dronsuab/IR_Project/Specs/Informes/CapturaIvan.PNG

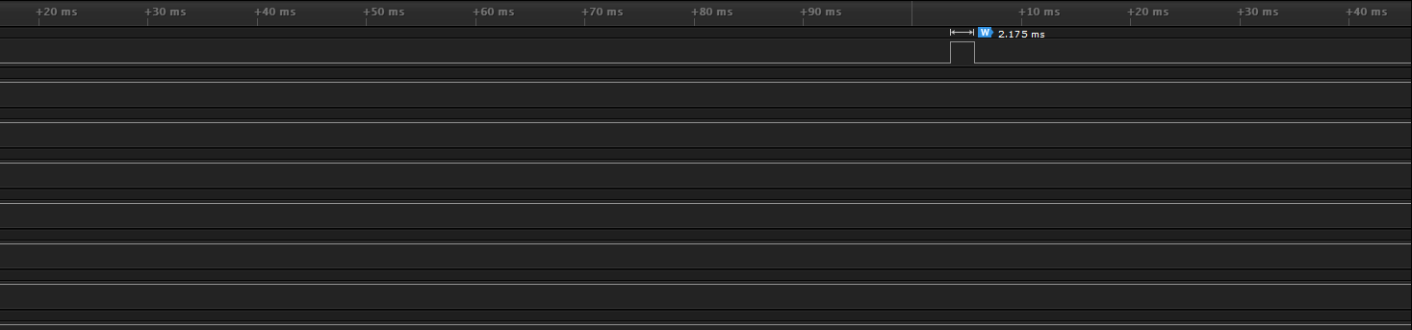
Specs/Informes/CapturaIvan.PNG
