dronsuab/IR_Project/Specs/NRST PIN.png

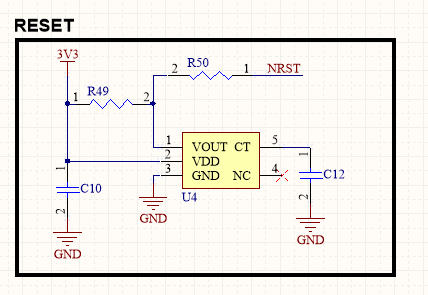
Specs/NRST PIN.png
