dronsuab/IR_Project/Specs/TFDU4101_CONNECTION.jpg

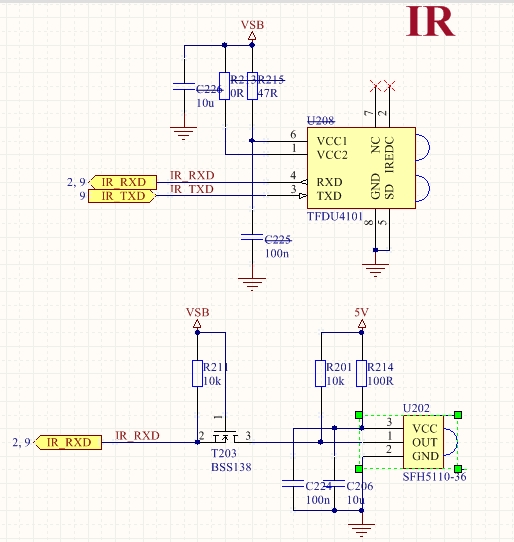
Specs/TFDU4101_CONNECTION.jpg
