dronsuab/IR_Project/Specs/VBAT.png

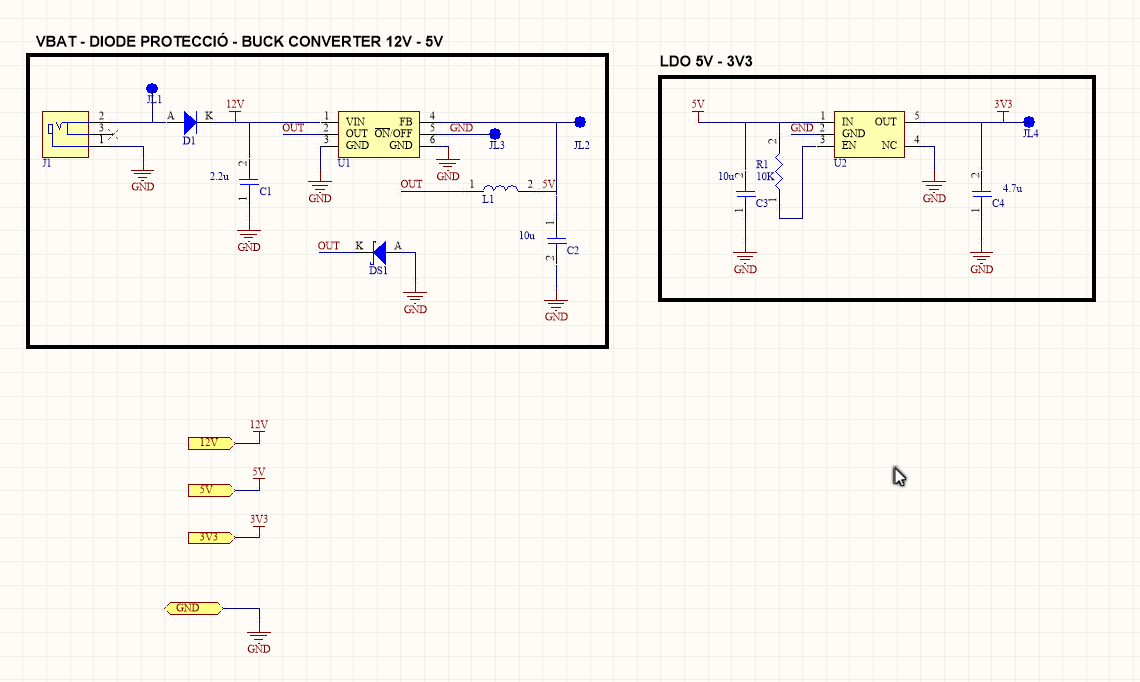
Specs/VBAT.png
