dronsuab/IR_Project/PCB/Kicad PCB/PCB/IDFReport_prueba.html

Altium customize

# IDF File Translation Report

Date: | | 6/22/2018
Time: | | 10:10:23 AM
Elapsed Time: | | 00:00:00
PCB Filename | : | PCB1.PcbDoc
IDF Board Filename | : | C:\Users\FV4IYP0\Documents\GitHub\IR_Project\PCB\Kicad PCB\PCB\prueba.emn
IDF Library Filename | : | C:\Users\FV4IYP0\Documents\GitHub\IR_Project\PCB\Kicad PCB\PCB\prueba.emp

Load Errors

Back to top

Import Errors

Back to top

Load Warnings

Back to top

Import Warnings

One or more via/pin drilled holes were ignored

Back to top

Errors

Back to top

Warnings

Back to top
