dronsuab/IR_Project/PCB/Kicad PCB/PCB/ST_IRDA_PCB.pdf

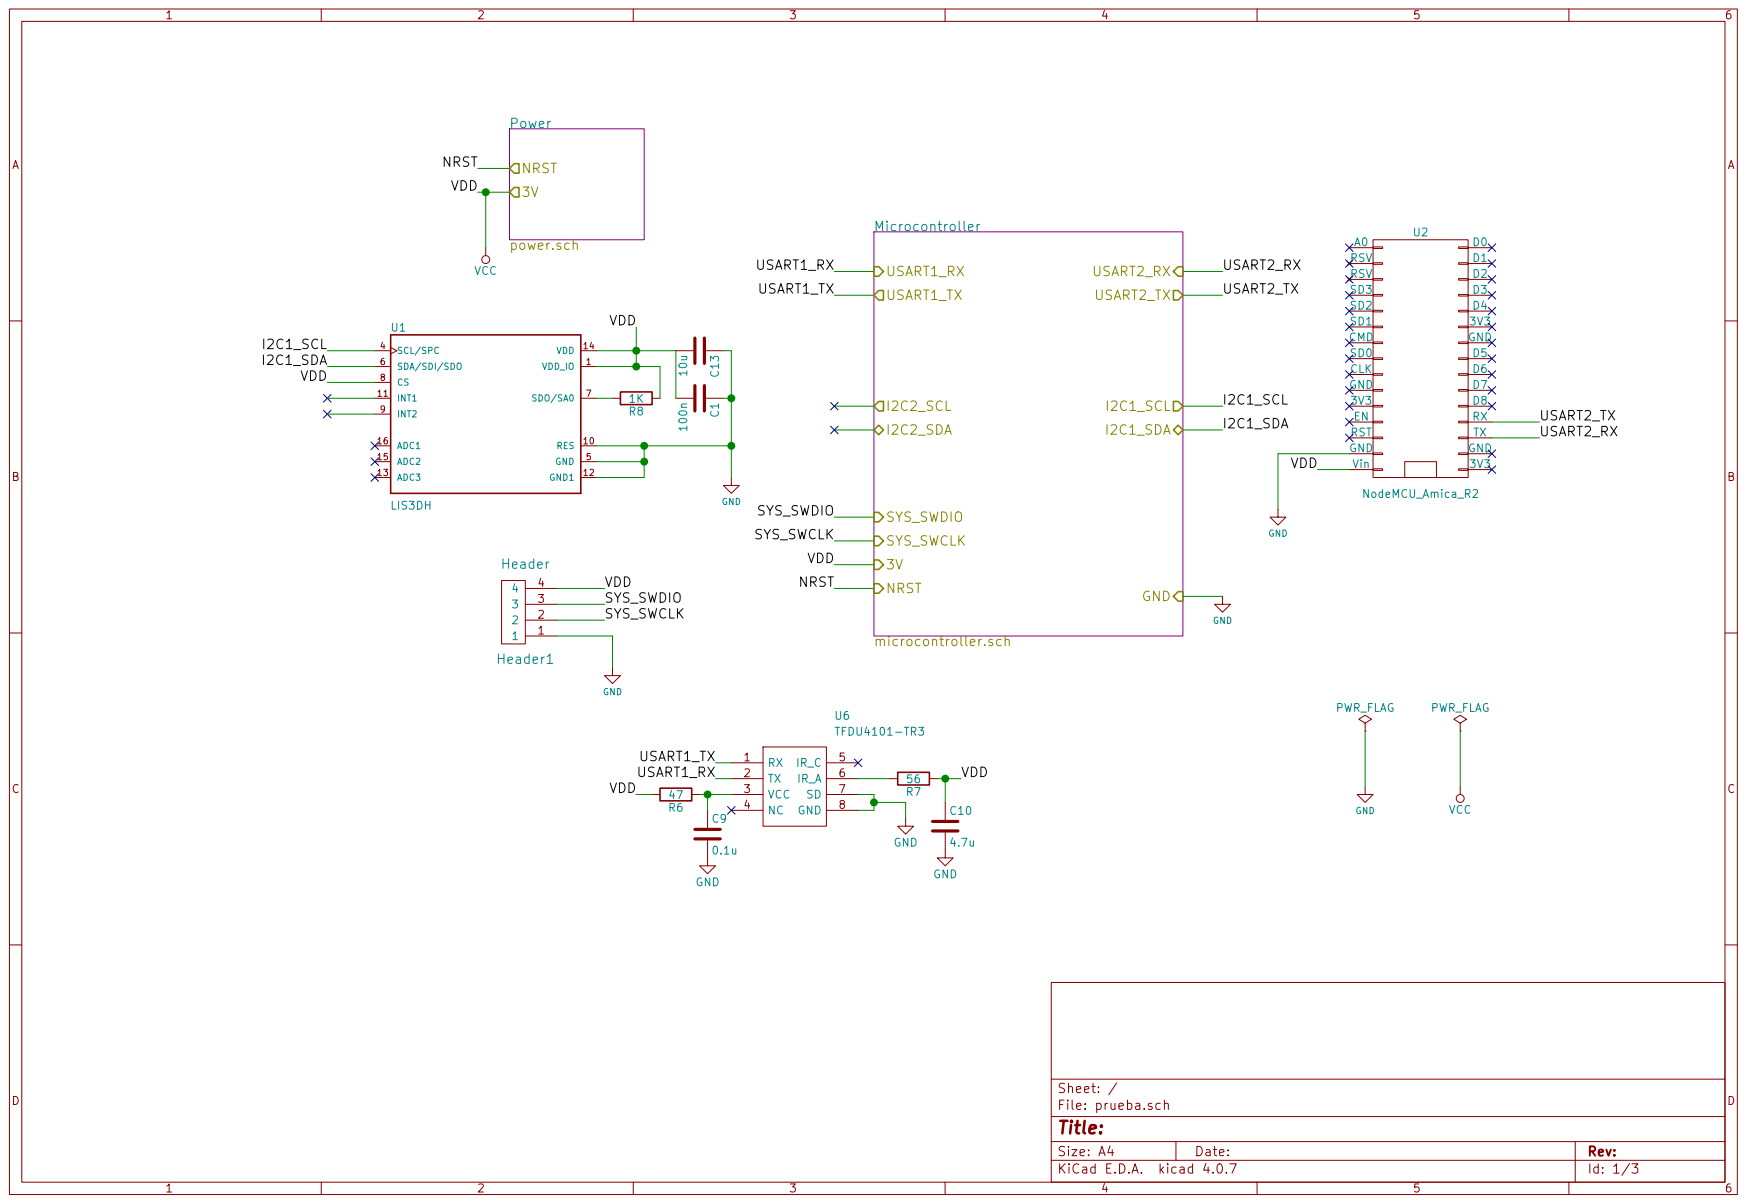
[picture p9: page 1]

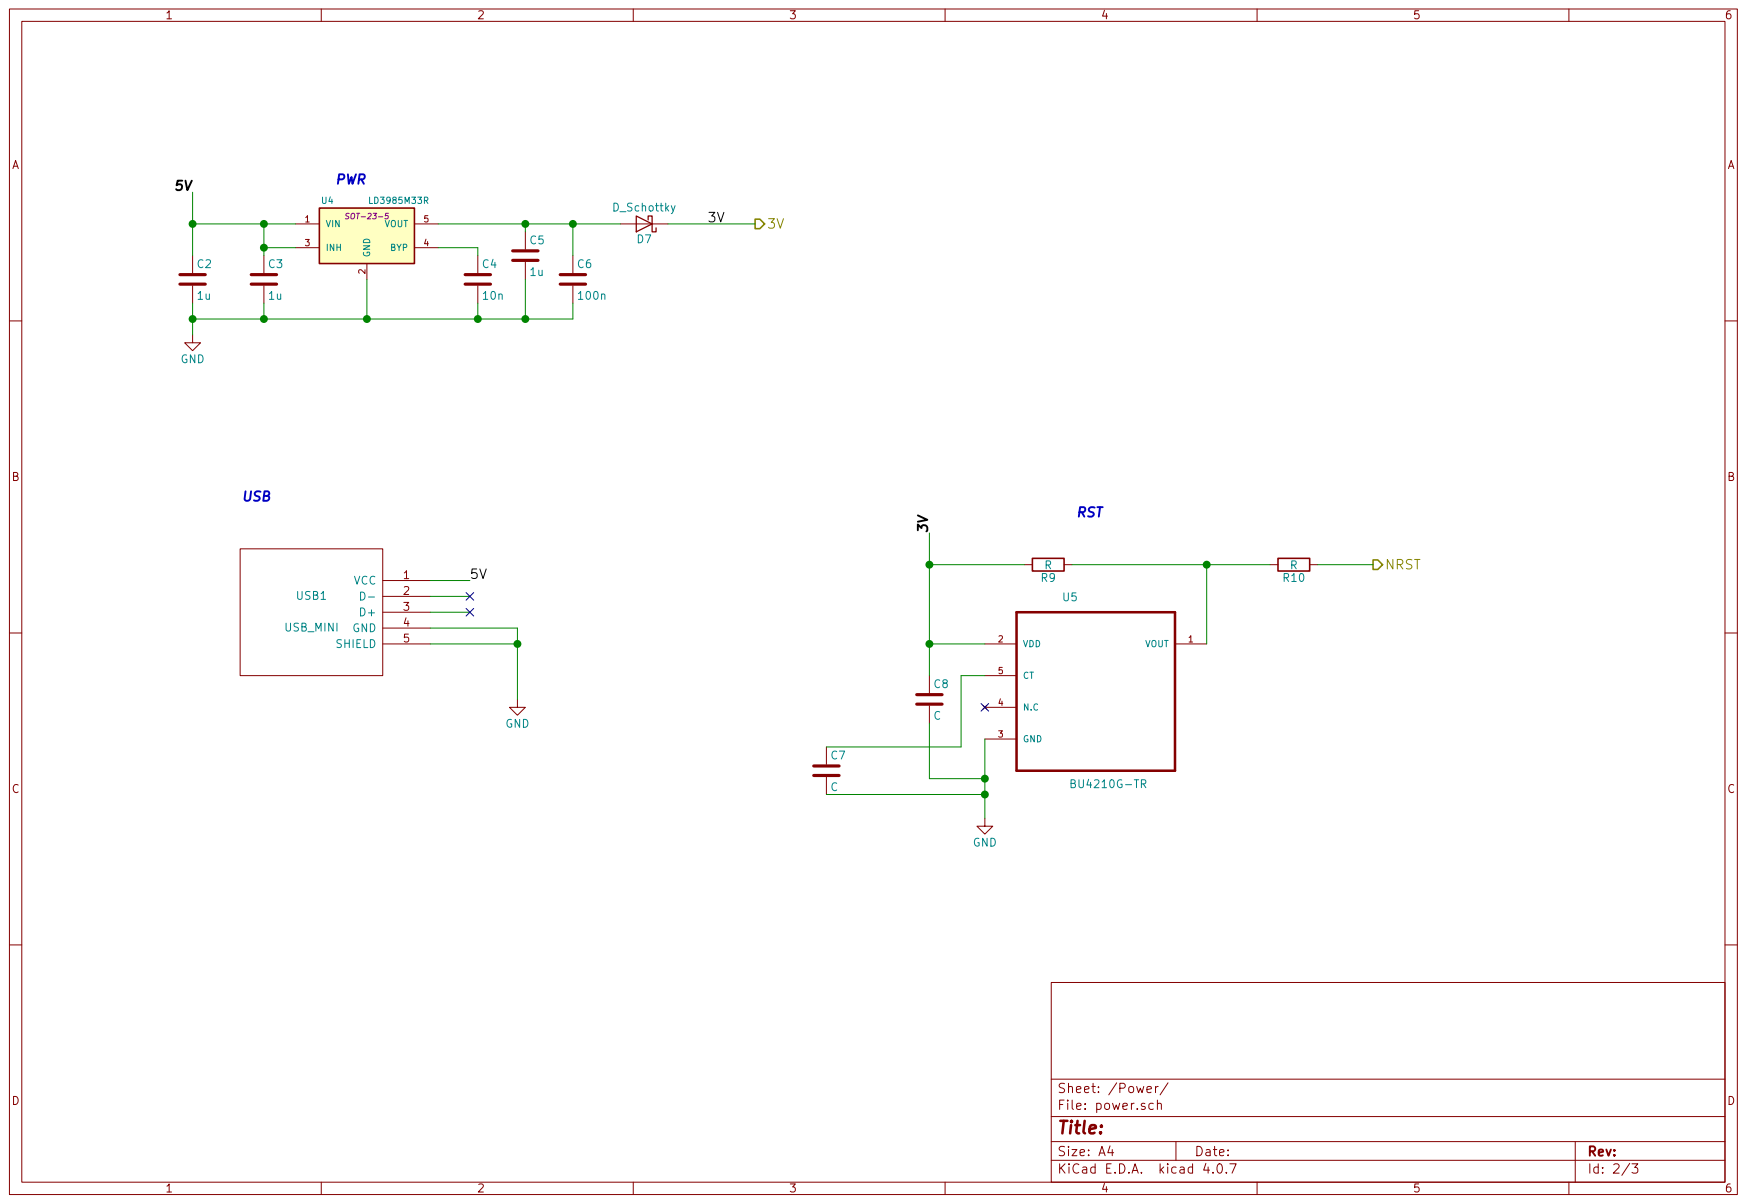
[picture p10: page 2]

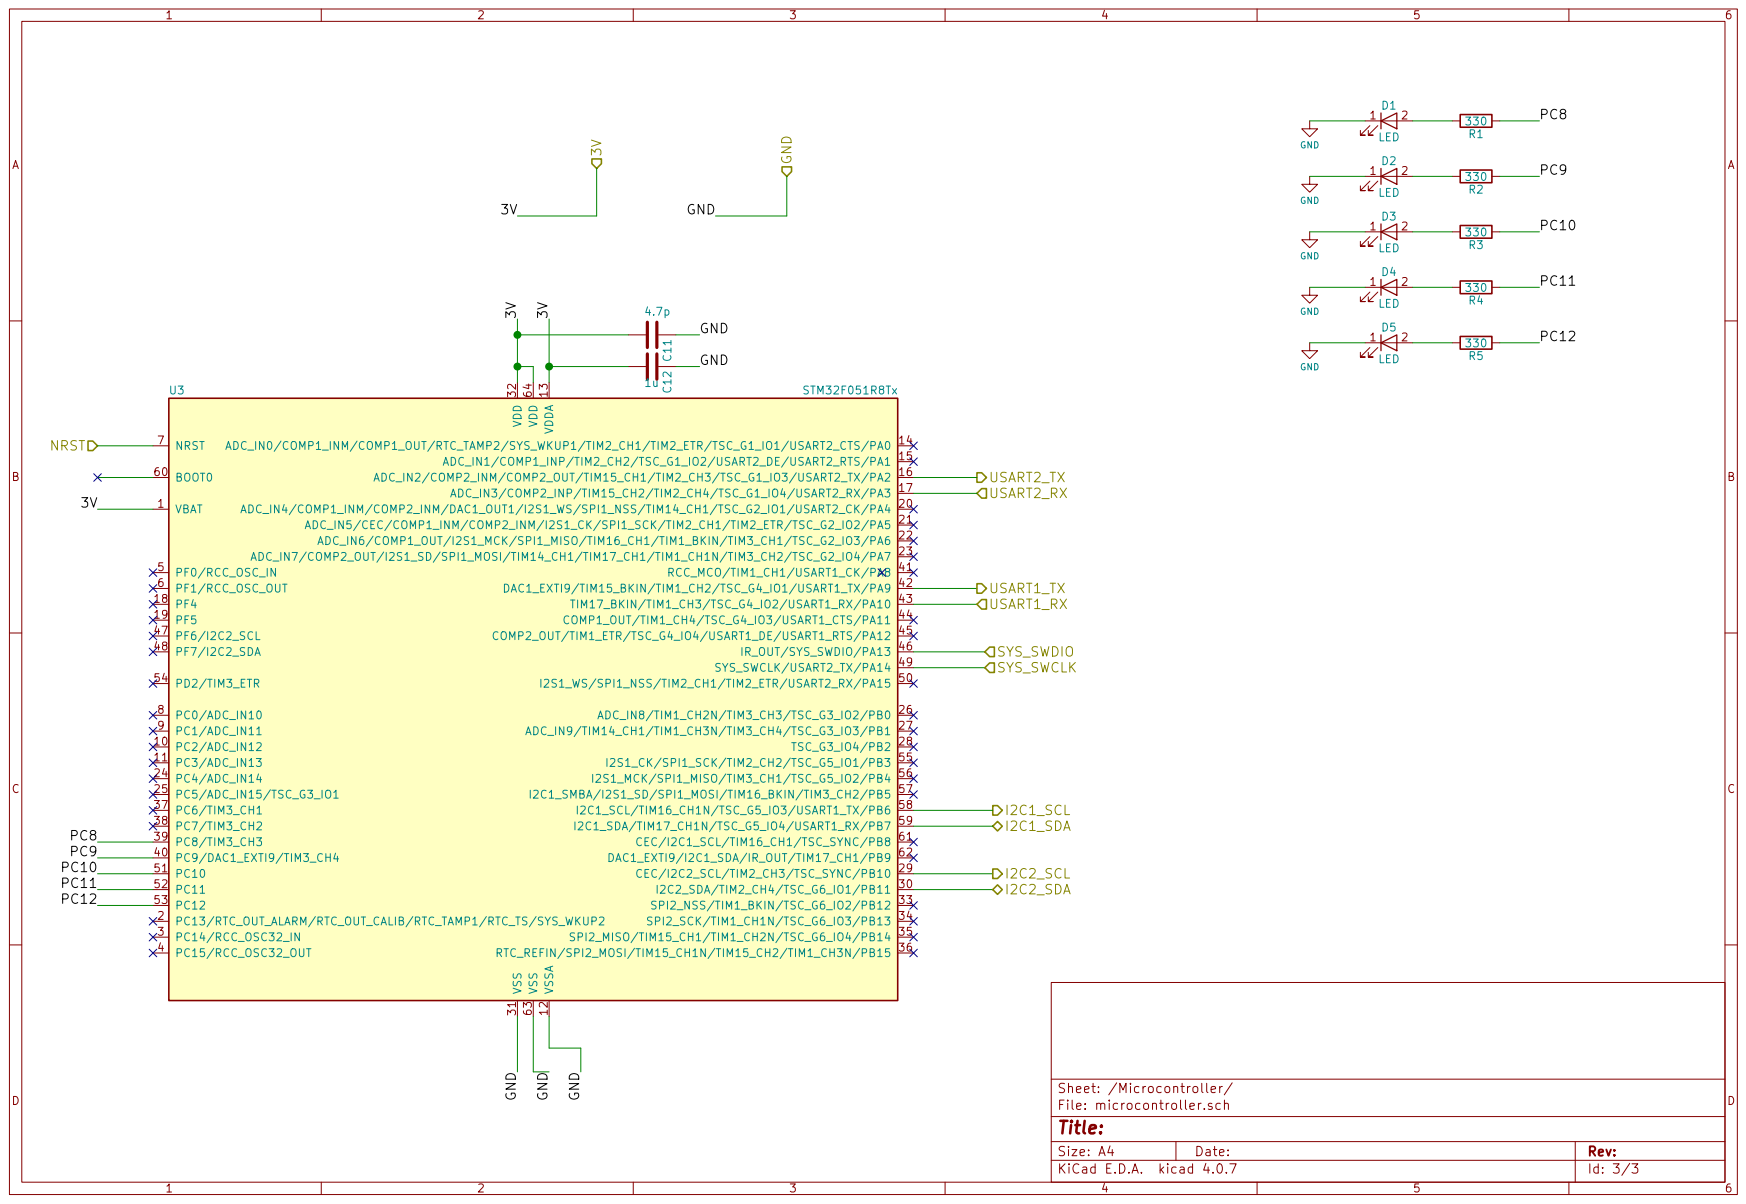
[picture p11: page 3]
