dronsuab/IR_Project/(list of files, drawings)

Other design files:
PCB/Kicad PCB/PCB/prueba2.dsn
PCB/Kicad PCB/PCB/prueba3.dsn
PCB/Kicad PCB/PCB/prueba4.dsn
PCB/Kicad PCB/PCB/prueba5.dsn
PCB/Kicad PCB/PCB/prueba.dsn
PCB/Kicad PCB/PCB/prueba.pcb
