dronsuab/IR_Project/PCB/Kicad PCB/PCB/prueba.kicad_pcb

## KiCad design PCB/Kicad PCB/PCB/prueba.kicad_pcb (2018-07-02)

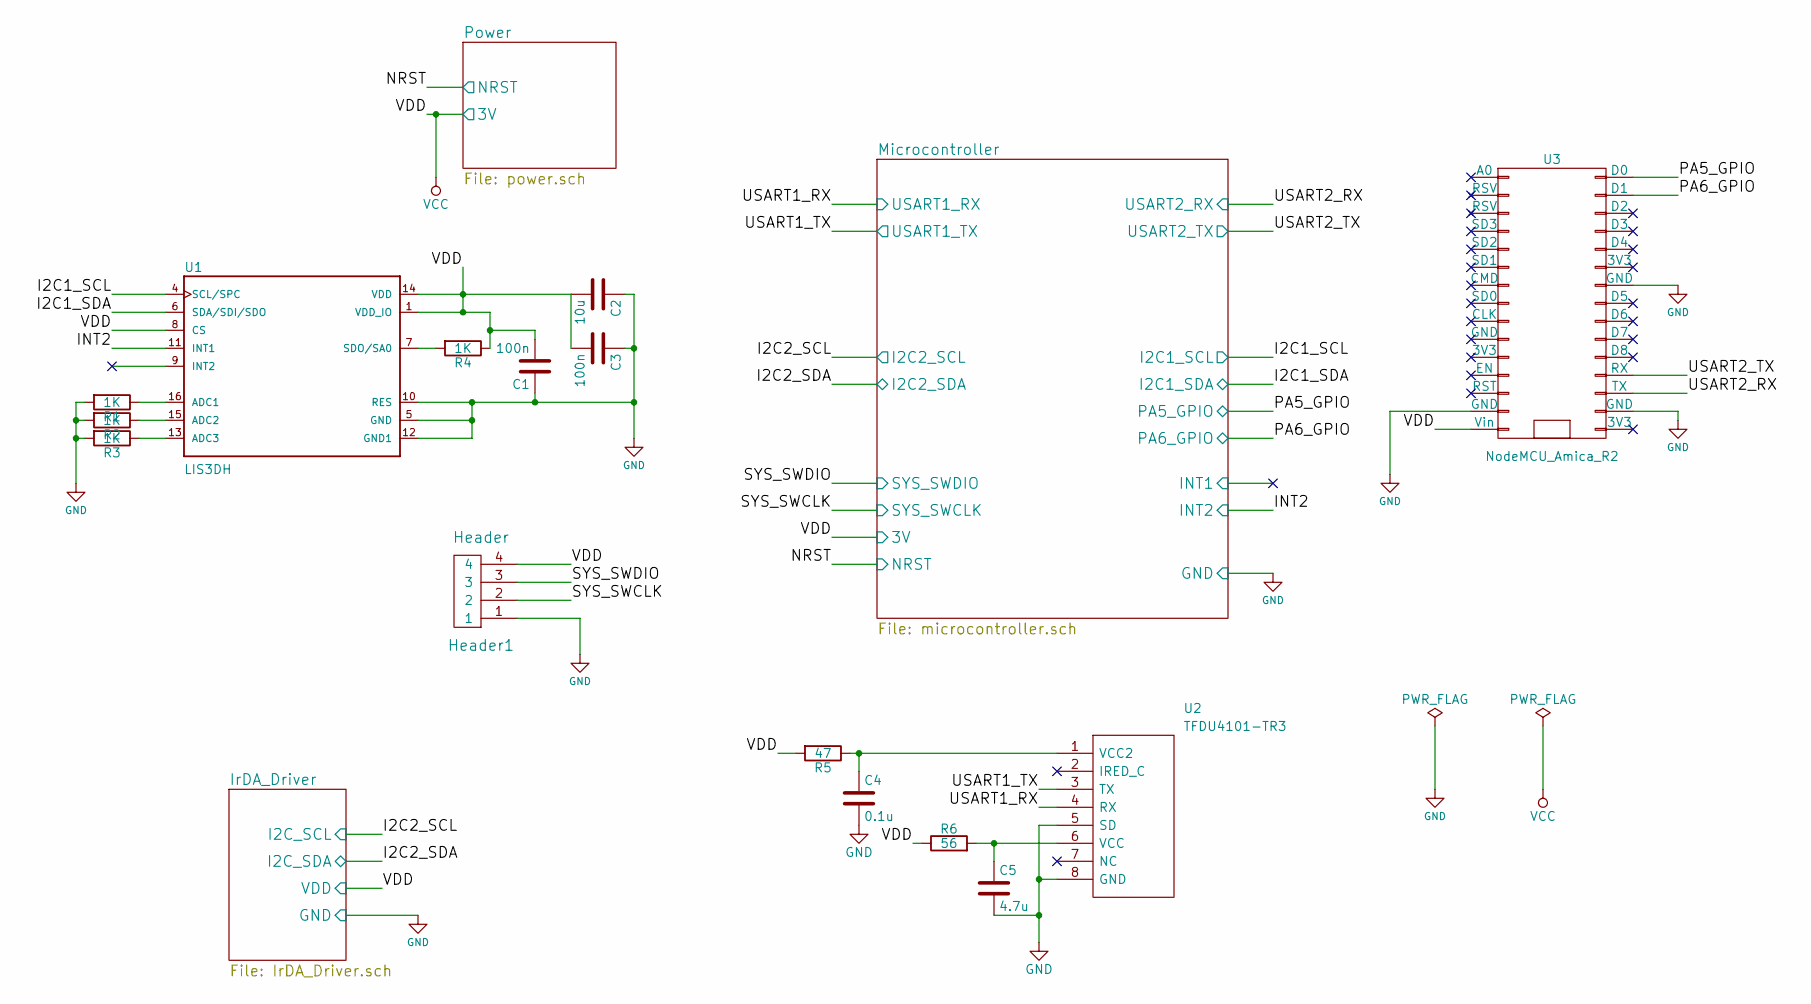
[picture p12: schematic prueba.sch]

Parts:
C1, C3: 100n; C_0201
C2: 10u; C_0201
C4: 0.1u; C_0201
C5: 4.7u; C_0201
Header1: Header; DIP-4_W7.62mm
R1, R2, R3, R4: 1K; R_0201
R5: 47; R_0201
R6: 56; R_0201
U1: LIS3DH; PQFN50P300X300X100-16N
U2: TFDU4101-TR3; Manufacturer_Part_Number TFDU4101-TR3
U3: NodeMCU_Amica_R2

Connections:
/I2C1_SCL: U1.4 (SCL/SPC); also elsewhere on the board
/I2C1_SDA: U1.6 (SDA/SDI/SDO); also elsewhere on the board
/INT2: U1.11 (INT1); also elsewhere on the board
/PA5_GPIO: U3.30 (D0); also elsewhere on the board
/PA6_GPIO: U3.29 (D1); also elsewhere on the board
/SYS_SWCLK: Header1.2; also elsewhere on the board
/SYS_SWDIO: Header1.3; also elsewhere on the board
/USART1_RX: U2.4 (RX); also elsewhere on the board
/USART1_TX: U2.3 (TX); also elsewhere on the board
/USART2_RX: U3.18 (TX); also elsewhere on the board
/USART2_TX: U3.19 (RX); also elsewhere on the board
GND: C1.1, C2.1, C3.1, C4.2, C5.2, Header1.1, R1.2, R2.2, R3.2, U1.5 (GND), U1.10 (RES), U1.12 (GND1), U2.5 (SD), U2.8 (GND), U3.14 (GND), U3.17 (GND), U3.24 (GND); also elsewhere on the board
unnamed: C4.1, R5.1, U2.1 (VCC2)
unnamed: C5.1, R6.2, U2.6 (VCC)
unnamed: R1.1, U1.16 (ADC1)
unnamed: R2.1, U1.15 (ADC2)
unnamed: R3.1, U1.13 (ADC3)
unnamed: R4.2, U1.7 (SDO/SA0)
VCC: C1.2, C2.2, C3.2, Header1.4, R4.1, R5.2, R6.1, U1.1 (VDD_IO), U1.8 (CS), U1.14 (VDD), U3.15 (Vin); also elsewhere on the board

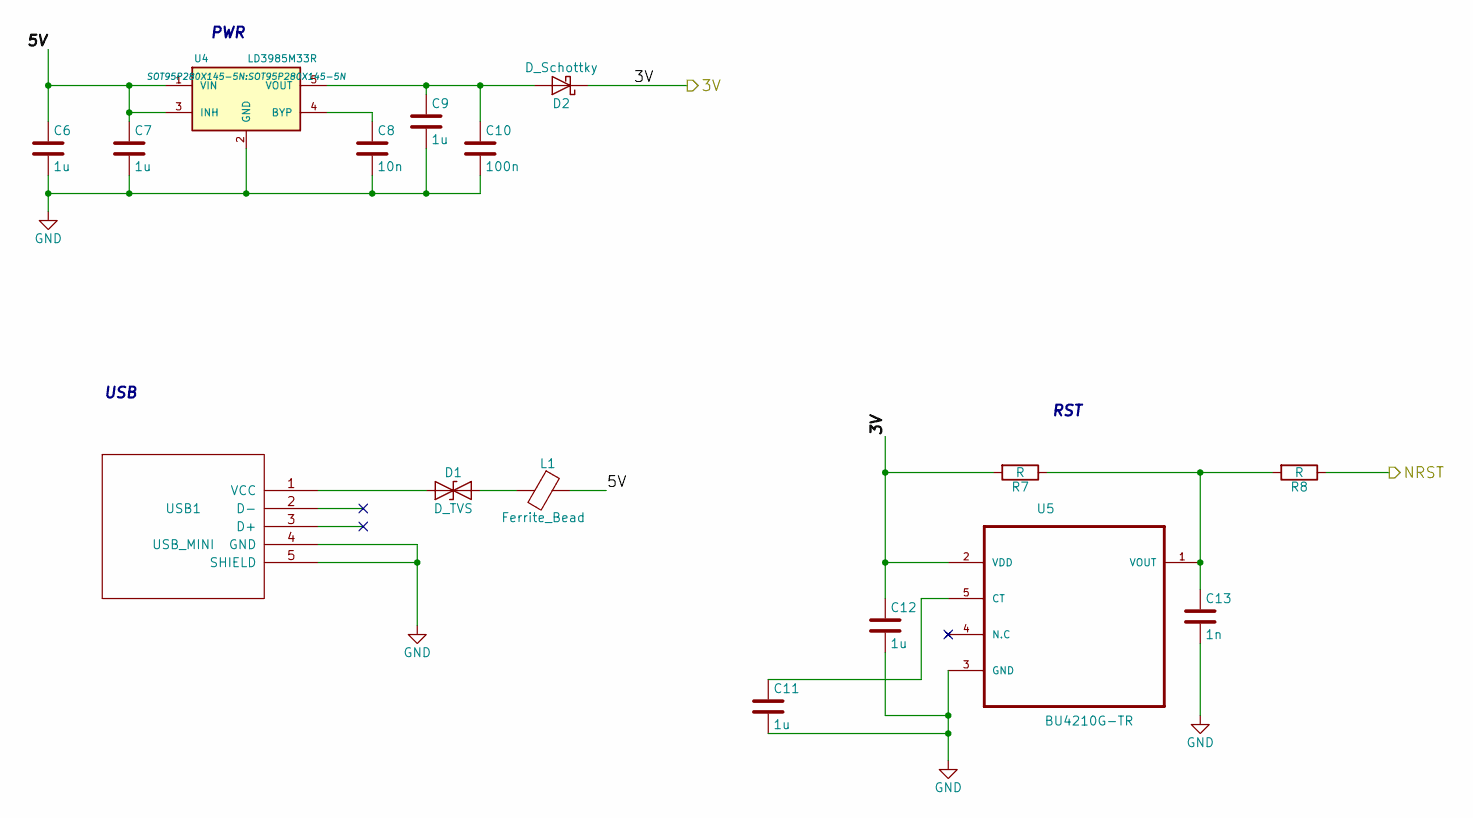
[picture p13: schematic power.sch]

Parts:
C6, C7, C9, C11, C12: 1u; C_0201
C8: 10n; C_0201
C10: 100n; C_0201
C13: 1n; C_0201
D1: D_TVS; D_0603
D2: D_Schottky; D_0603
L1: Ferrite_Bead; 0603-NO
R7, R8: R; R_0201
U4: LD3985M33R; SOT95P280X145-5N
U5: BU4210G-TR; SOT95P280X125-5N
USB1: USB_MINI; HRS_ZX62D-B-5P8

Connections:
/NRST: R8.1; also elsewhere on the board
/Power/5V: C6.1, C7.1, L1.1, U4.1 (VIN), U4.3 (INH)
GND: C6.2, C7.2, C8.2, C9.2, C10.2, C11.2, C12.2, C13.2, U4.2 (GND), U5.3 (GND), USB1.4 (GND), USB1.5 (SHIELD); also elsewhere on the board
unnamed: C8.1, U4.4 (BYP)
unnamed: C9.1, C10.1, D2.2 (A), U4.5 (VOUT)
unnamed: C11.1, U5.5 (CT)
unnamed: C13.1, R7.1, R8.2, U5.1 (VOUT)
unnamed: D1.1 (A1), USB1.1 (VCC)
unnamed: D1.2 (A2), L1.2
VCC: C12.1, D2.1 (K), R7.2, U5.2 (VDD); also elsewhere on the board

Notes on the sheet:
PWR
USB
RST

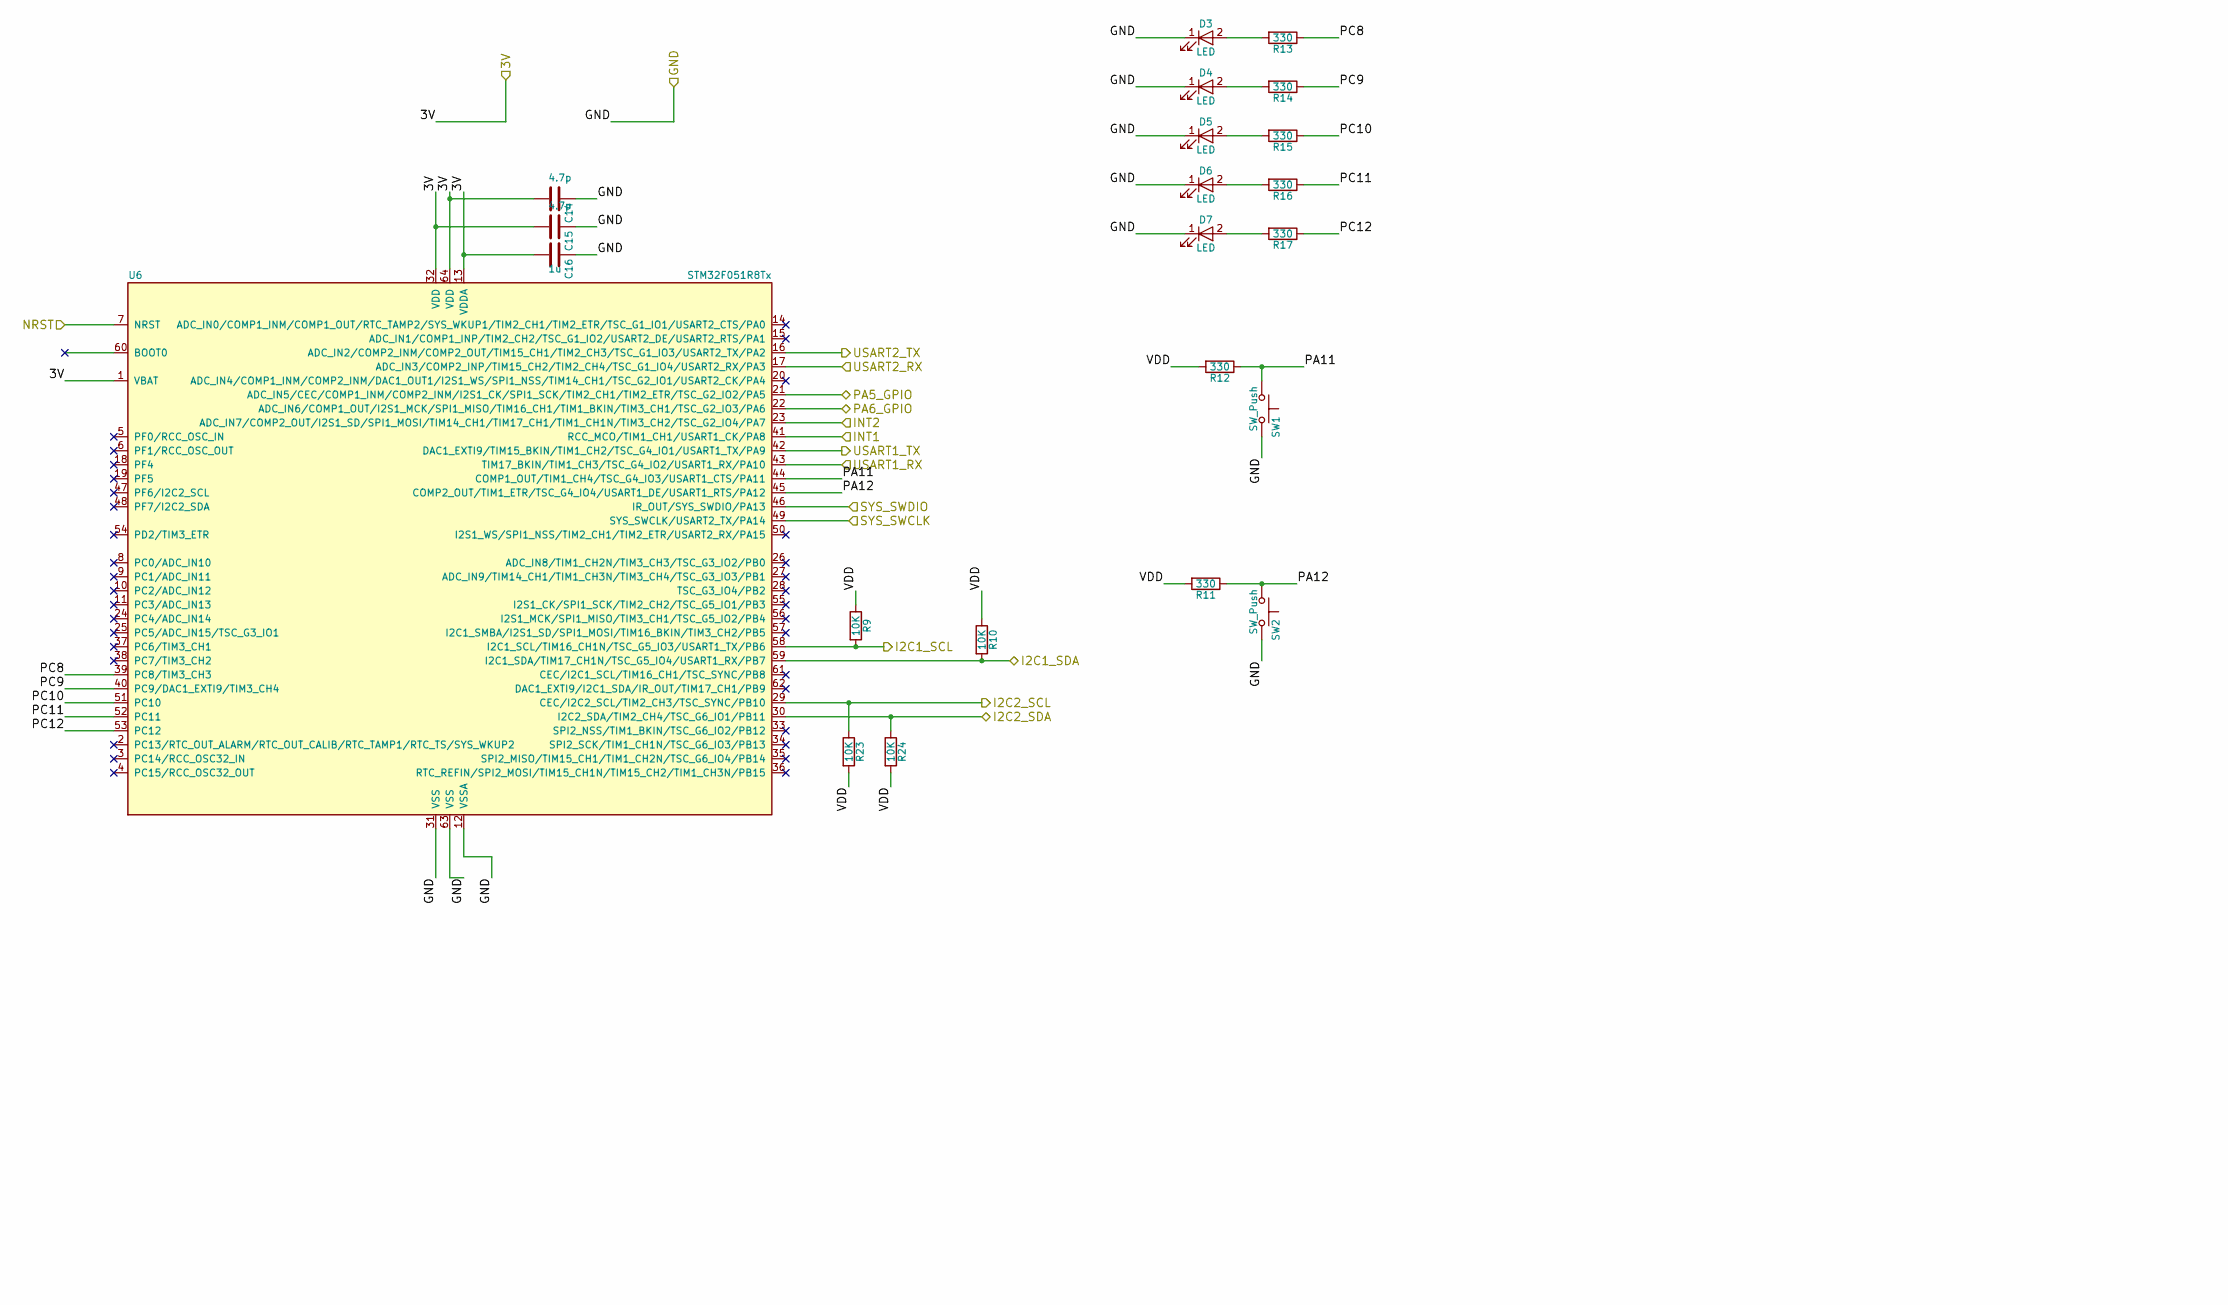
[picture p14: schematic microcontroller.sch, part in row 1, column 1]

Parts:
C14, C15: 4.7p; C_0201
C16: 1u; C_0201
D3, D4, D5, D6, D7: LED; LED-L1T2_LUMILEDS
R9, R10, R23, R24: 10K; R_0201
R11, R12, R13, R14, R15, R16, R17: 330; R_0201
SW1, SW2: SW_Push; Nidec_Copal_SH-7010A
U6: STM32F051R8Tx; QFP50P1200X1200X160-64N

Connections:
/I2C1_SCL: R9.2, U6.58 (I2C1_SCL/TIM16_CH1N/TSC_G5_IO3/USART1_T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); also elsewhere on the board
/I2C1_SDA: R10.2, U6.59 (I2C1_SDA/TIM17_CH1N/TSC_G5_IO4/USART1_R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); also elsewhere on the board
/I2C2_SCL: R23.1, U6.29 (CEC/I2C2_SCL/TIM2_CH3/TSC_SYNC/PB10); also elsewhere on the board
/I2C2_SDA: R24.1, U6.30 (I2C2_SDA/TIM2_CH4/TSC_G6_IO1/PB11); also elsewhere on the board
/INT2: U6.23 (ADC_IN7/COMP2_OUT/I2S1_SD/SPI1_MOSI/TIM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); also elsewhere on the board
/Microcontroller/INT1: U6.41 (RCC_MCO/TIM1_CH1/USART1_CK/PA8)
/Microcontroller/PA11: R12.1, SW1.1, U6.44 (COMP1_OUT/TIM1_CH4/TSC_G4_IO3/USART1_CT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)
/Microcontroller/PA12: R11.1, SW2.1, U6.45 (COMP2_OUT/TIM1_ETR/TSC_G4_IO4/USART1_DE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)
/Microcontroller/PC8: R13.1, U6.39 (PC8/TIM3_CH3)
/Microcontroller/PC9: R14.1, U6.40 (PC9/DAC1_EXTI9/TIM3_CH4)
/Microcontroller/PC10: R15.1, U6.51 (PC10)
/Microcontroller/PC11: R16.1, U6.52 (PC11)
/Microcontroller/PC12: R17.1, U6.53 (PC12)
/Microcontroller/VDD: R9.1, R10.1, R11.2, R12.2, R23.2, R24.2
/NRST: U6.7 (NRST); also elsewhere on the board
/PA5_GPIO: U6.21 (ADC_IN5/CEC/COMP1_INM/COMP2_INM/I2S1_CK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); also elsewhere on the board
/PA6_GPIO: U6.22 (ADC_IN6/COMP1_OUT/I2S1_MCK/SPI1_MISO/TI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); also elsewhere on the board
/SYS_SWCLK: U6.49 (SYS_SWCLK/USART2_TX/PA14); also elsewhere on the board
/SYS_SWDIO: U6.46 (IR_OUT/SYS_SWDIO/PA13); also elsewhere on the board
/USART1_RX: U6.43 (TIM17_BKIN/TIM1_CH3/TSC_G4_IO2/USART1_R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); also elsewhere on the board
/USART1_TX: U6.42 (DAC1_EXTI9/TIM15_BKIN/TIM1_CH2/TSC_G4_I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); also elsewhere on the board
/USART2_RX: U6.17 (ADC_IN3/COMP2_INP/TIM15_CH2/TIM2_CH4/TS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); also elsewhere on the board
/USART2_TX: U6.16 (ADC_IN2/COMP2_INM/COMP2_OUT/TIM15_CH1/T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); also elsewhere on the board
GND: C14.1, C15.1, C16.1, D3.1 (K), D4.1 (K), D5.1 (K), D6.1 (K), D7.1 (K), SW1.2, SW2.2, U6.12 (VSSA), U6.31 (VSS), U6.63 (VSS); also elsewhere on the board
unnamed: D3.2 (A), R13.2
unnamed: D4.2 (A), R14.2
unnamed: D5.2 (A), R15.2
unnamed: D6.2 (A), R16.2
unnamed: D7.2 (A), R17.2
VCC: C14.2, C15.2, C16.2, U6.1 (VBAT), U6.13 (VDDA), U6.32 (VDD), U6.64 (VDD); also elsewhere on the board

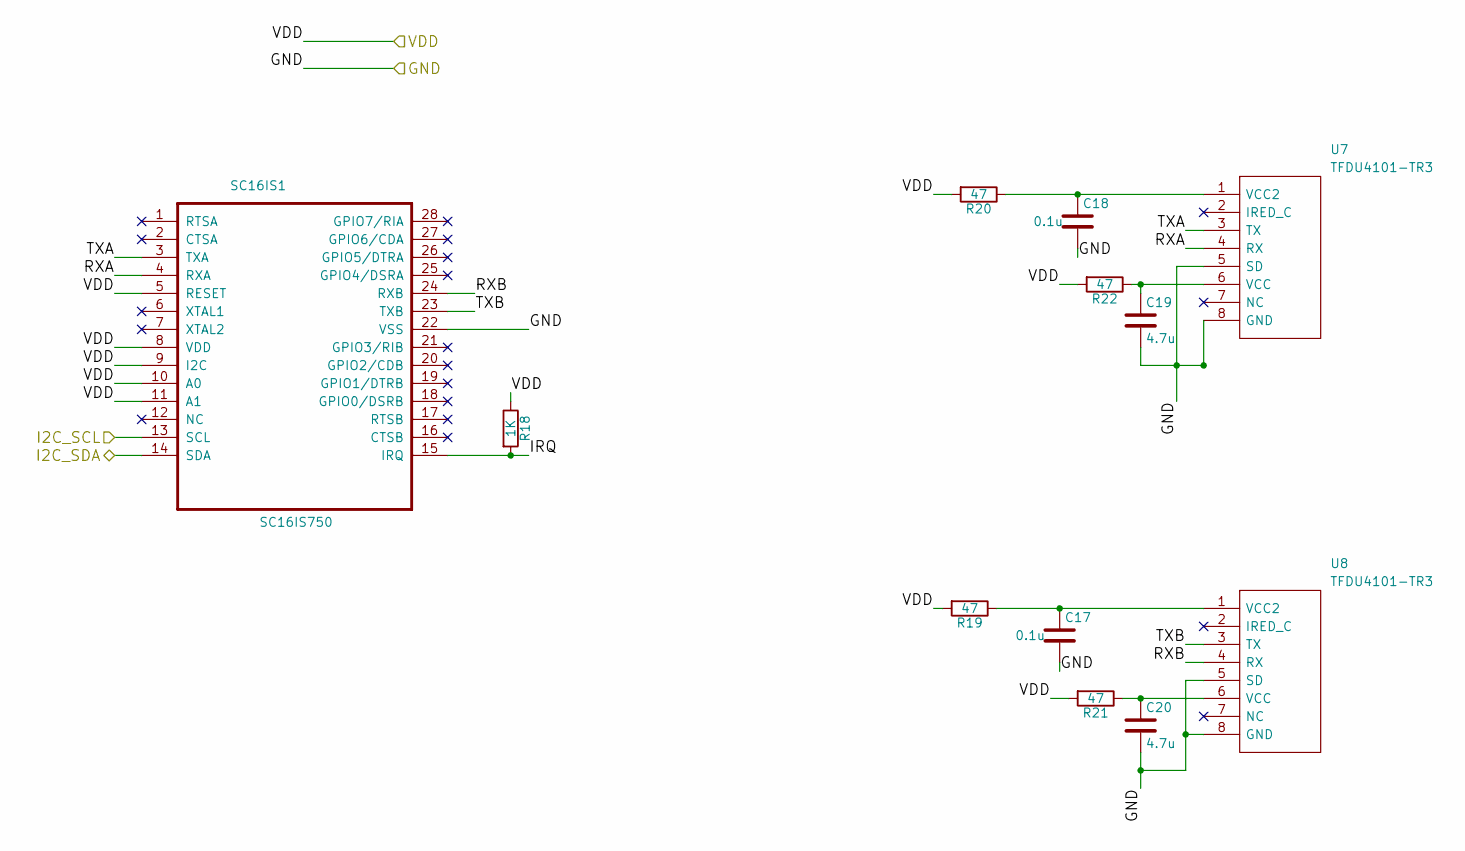
[picture p15: schematic IrDA_Driver.sch]

Parts:
C17, C18: 0.1u; C_0201
C19, C20: 4.7u; C_0201
R18: 1K; R_0201
R19, R20, R21, R22: 47; R_0201
SC16IS1: SC16IS750; SOP65P640X110-28N
U7, U8: TFDU4101-TR3; Manufacturer_Part_Number TFDU4101-TR3

Connections:
/I2C2_SCL: SC16IS1.13 (SCL); also elsewhere on the board
/I2C2_SDA: SC16IS1.14 (SDA); also elsewhere on the board
/IrDA_Driver/IRQ: R18.2, SC16IS1.15 (IRQ)
/IrDA_Driver/RXA: SC16IS1.4 (RXA), U7.4 (RX)
/IrDA_Driver/RXB: SC16IS1.24 (RXB), U8.4 (RX)
/IrDA_Driver/TXA: SC16IS1.3 (TXA), U7.3 (TX)
/IrDA_Driver/TXB: SC16IS1.23 (TXB), U8.3 (TX)
GND: C17.2, C18.2, C19.2, C20.2, SC16IS1.22 (VSS), U7.5 (SD), U7.8 (GND), U8.5 (SD), U8.8 (GND); also elsewhere on the board
unnamed: C17.1, R19.1, U8.1 (VCC2)
unnamed: C18.1, R20.1, U7.1 (VCC2)
unnamed: C19.1, R22.1, U7.6 (VCC)
unnamed: C20.1, R21.1, U8.6 (VCC)
VCC: R18.1, R19.2, R20.2, R21.2, R22.2, SC16IS1.5 (RESET), SC16IS1.8 (VDD), SC16IS1.9 (I2C), SC16IS1.10 (A0), SC16IS1.11 (A1); also elsewhere on the board

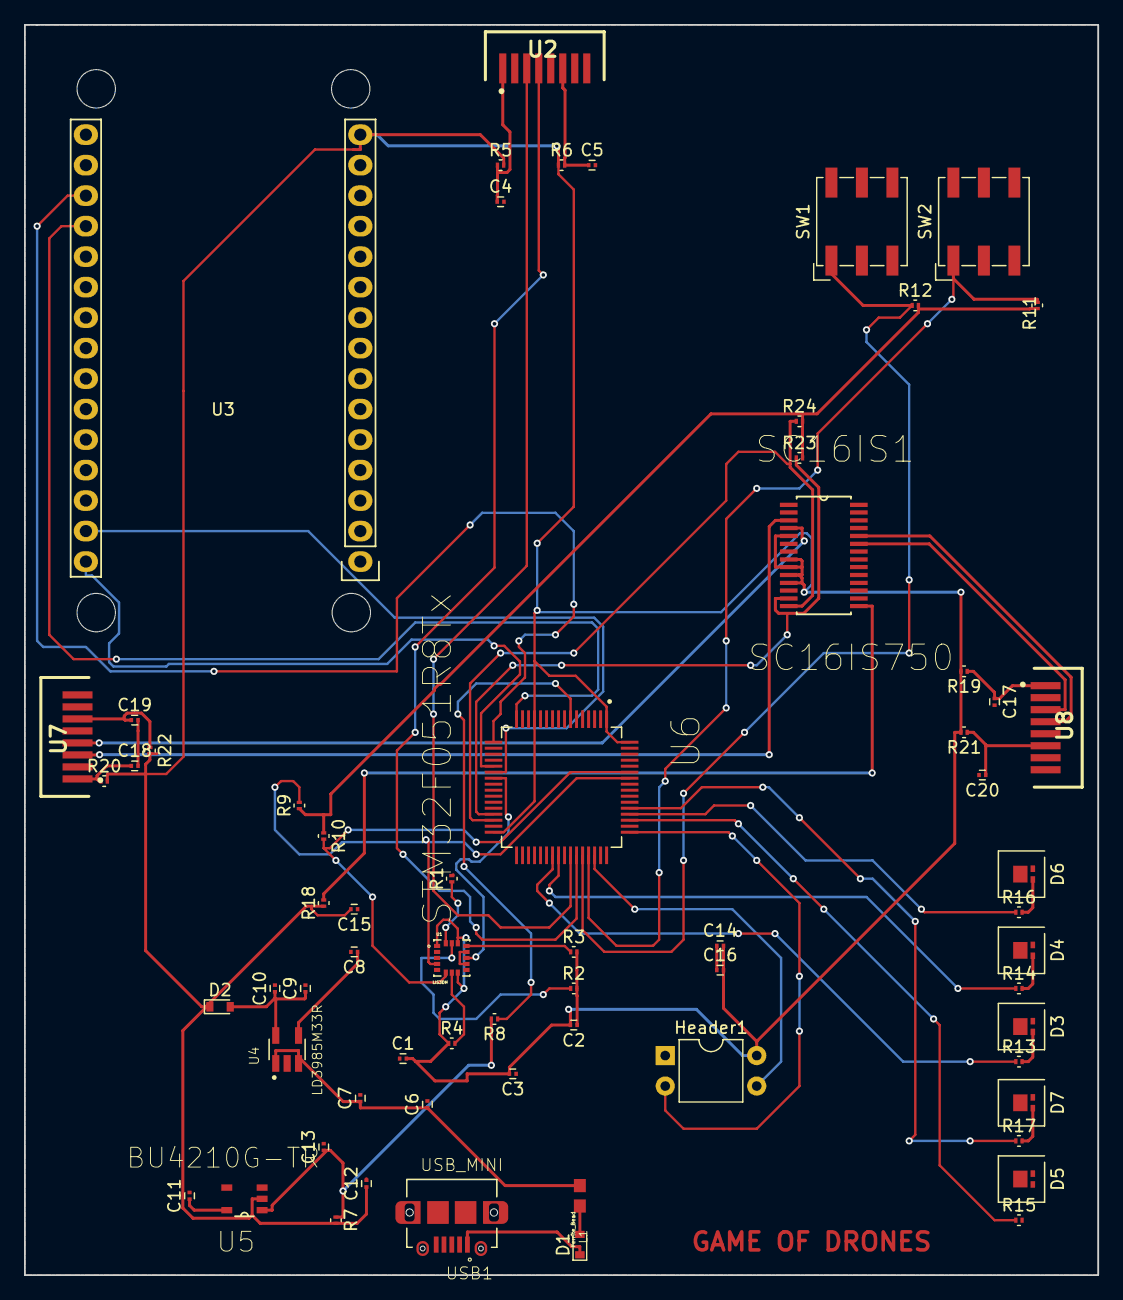
[picture p16: board prueba.kicad_pcb from above]

Board: 2 copper layers, 89.4 x 104.1 mm, 65 parts (0 on the bottom side), 51 nets.
