dronsuab/IR_Project/Code/FreeRTOSEx.ioc

Mcu.UserName=STM32F051R8Tx
PA10.Signal=USART1_RX
PA2.Signal=USART2_TX
PA3.Signal=USART2_RX
PA9.Signal=USART1_TX
