dronsuab/IR_Project/Code/Src/HAL/GPIO/custom/GPIO_map.h

/*
 * GPIO_map.h
 *
 *  Created on: 15 oct. 2017
 *      Author: Iván
 */

#ifndef HAL_GPIO_CUSTOM_GPIO_MAP_H_
#define HAL_GPIO_CUSTOM_GPIO_MAP_H_


#include "common.h"

typedef enum
{

	GPIO_USART1_TX,
	GPIO_USART1_RX,

	GPIO_USART2_TX,
	GPIO_USART2_RX,

	GPIO_LED_3,
	GPIO_LED_4,

	USER_BUTTON_B1,

	GPIO_1,

    NUM_OF_GPIO
} eGPIO;

#endif /* HAL_GPIO_CUSTOM_GPIO_MAP_H_ */
