dronsuab/IR_Project/(commit log)

2017-10-22 UART
    UART for WIFI communication implemented.
2017-10-29 Interrupts implemented.
2017-11-18 uart implemented.
2017-11-19 uart example in main.c
2018-02-11 UART reception implemented.
2018-02-11 Completed code of UART reception.
2018-03-07 Button implemented to simulate a IR shot reception.
2018-05-25 Kicad parts folder created with the Vishay TFDU4101 transceiver.
2018-05-28 Device and TFD4101 libraries updated
2018-06-02 PCB created.
    [microcontroller.sch, power.sch, prueba.kicad_pcb, prueba.sch]
2018-06-04 SC16IS752IPW symbol implemented.
    [IrDA_Driver.sch, microcontroller.sch, power.sch, prueba.sch]
2018-06-12 SC16i52 connected with 2 transceivers.
    [IrDA_Driver.sch, microcontroller.sch, power.sch, prueba.sch]
2018-06-17 PCB updated to follow the ECM rules.
    [IrDA_Driver.sch, microcontroller.sch]
2018-06-18 Netlist finished.
    [IrDA_Driver.sch, microcontroller.sch, power.sch, prueba.sch]
2018-06-18 PCBnet updated.
2018-06-18 PCB schematic updated.
    [IrDA_Driver.sch, microcontroller.sch, power.sch, prueba.sch]
2018-06-22 PCB updated with partial routing
    [prueba.dsn, prueba.pcb, prueba2.dsn, prueba3.dsn]
2018-06-27 PCB design updated
    [prueba.kicad_pcb, prueba4.dsn]
2018-06-29 PCB finished, without ground and vcc plane
    [prueba-B.Cu.gbl, prueba-B.Mask.gbs, prueba-B.SilkS.gbo, prueba-Edge.Cuts.gm1, prueba-F.Cu.gtl, prueba-F.Mask.gts, prueba-F.SilkS.gto, prueba-NPTH.drl]
2018-07-02 Ground Plane added.
    [prueba-B.Cu.gbl, prueba-B.Mask.gbs, prueba-B.SilkS.gbo, prueba-Edge.Cuts.gm1, prueba-F.Cu.gtl, prueba-F.Mask.gts, prueba-F.SilkS.gto, prueba.drl]
